JadenNeal/Balance-Car/balance-car.png

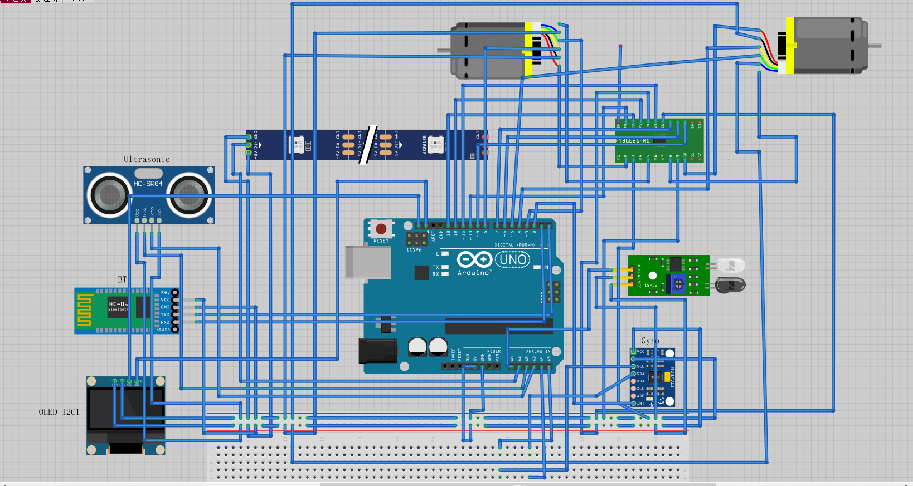
balance-car.png
