JadenNeal/Balance-Car/平衡小车原理图.pdf

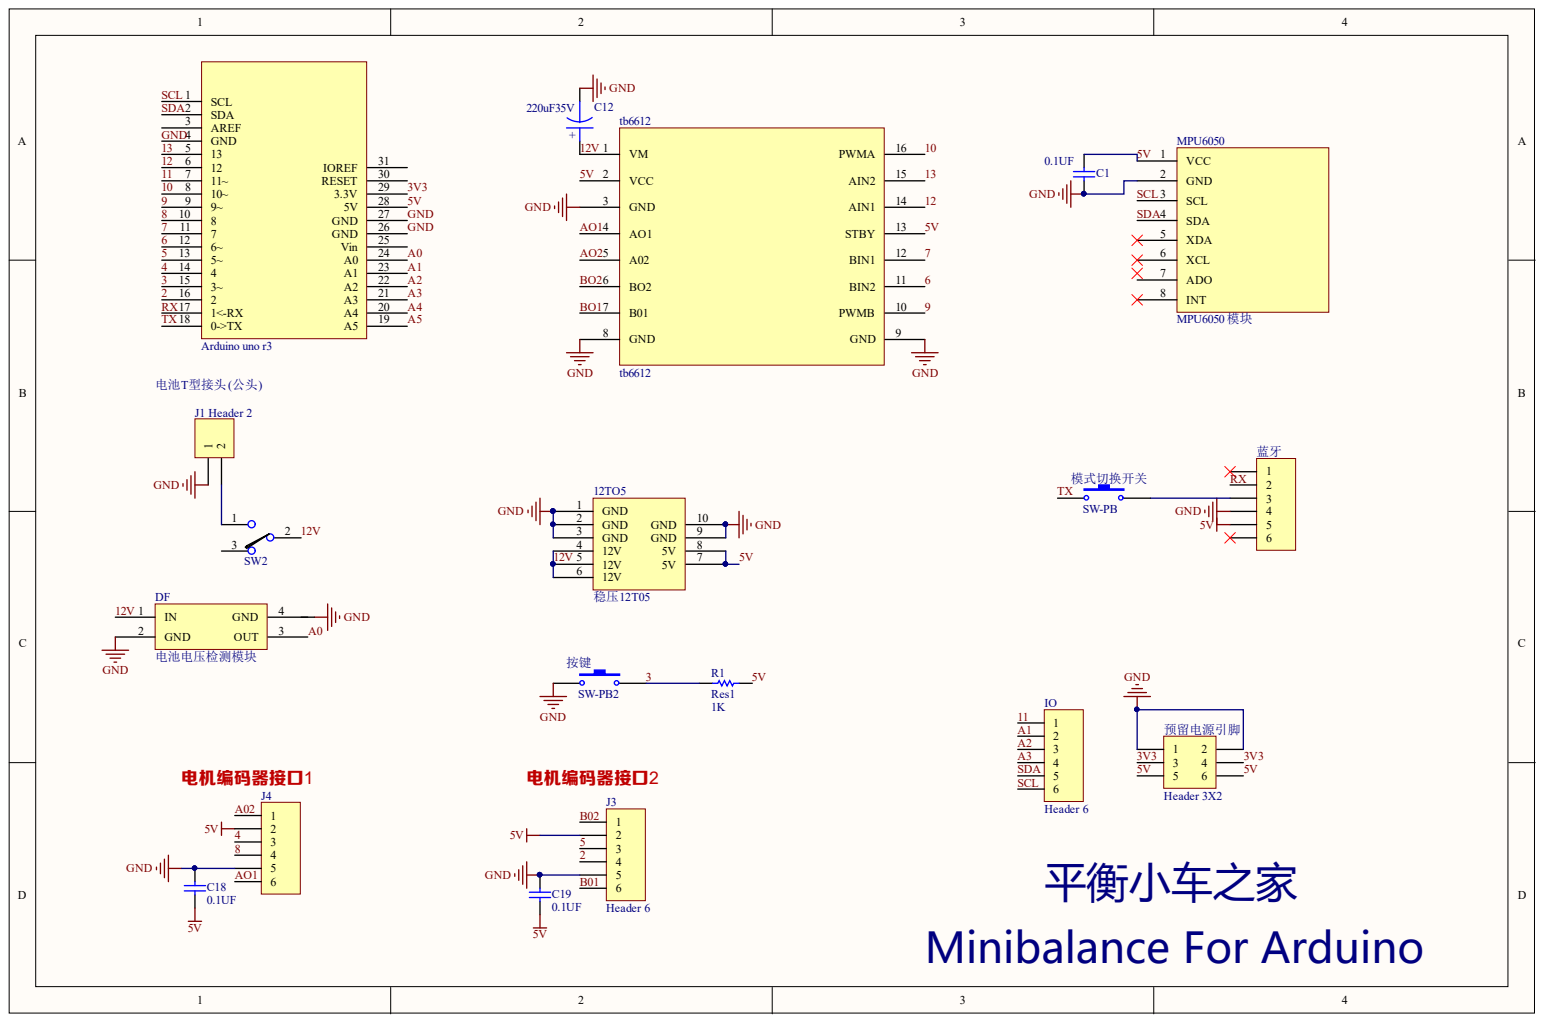
[picture p2: page 1]
