JadenNeal/Balance-Car/TEST_NOTES/20190708/离线测试笔记.md

# 离线测试笔记
目标：不使用USB接电脑供电，由于缺少直流电源线，故只能使用VIN接口给板子供电。
## 蓝牙控制电机
由于**蓝牙控制电机**的功能还没有测试好，故先测试这部分。

接线如下：

1. 蓝牙(HC-06)
    + RX -- 3（板子的发射端）
    + TX -- 2（板子的接收端）
    + GND -- GND
    + VCC -- VCC
2. 电机驱动(TB6612)
    + PWMA -- 10
    + AIN2 -- 13
    + AIN1 -- 12
    + STBY -- 11
    + BIN1 -- 7
    + BIN2 -- 6
    + PWMB -- 9
    + GND -- GND
    + VM -- 12
    + VCC -- 5V
    + AO1 -- AO1
    + AO2 -- AO2
    + BO2 -- BO2
    + BO1 -- BO1
3. 电机A
    + AO2
    + 5V
    + 4
    + 8
    + GND(并联0.1uf的旁路电容)
    + AO1（正极）
4. 电机B
    + BO1（正极）
    + GND(并联0.1uf的旁路电容)
    + 2
    + 5
    + BO2

完整程序在[这里](https://github.com/JadenNeal/Balance-Car/blob/master/others/BT_and_Motor/BT_and_Motor.ino)。

连接完成后，给板子上电，上传程序。然后用手机连接蓝牙，发送对应的数字即可控制电机转动。

## 串口控制电机
相比较蓝牙控制，串口控制就显得简单得多。思路就是读取发送到串口的数据，根据该数据控制电机转动。

只需要连接电机驱动模块和电机，程序在[这里](https://github.com/JadenNeal/Balance-Car/blob/master/others/Serial_and_Motor/Serial_and_Motor.ino)。

结果如下：
<div align="center">串口控制电机</div>

## 完整接线图
1. 超声波 
    + GND -- GND
    + Echo -- A3
    + Trig -- A2
    + VCC -- 5V
2. 蓝牙(HC-06) 
    + RX -- 1（板子的发射端）
    + TX -- 0（板子的接收端）
    + GND -- GND
    + VCC -- VCC
3. 显示屏(HW-102)  
    + VCC -- 5V
    + GND -- GND
    + SCL -- SCL
    + SDA -- SDA
4. 电机驱动(TB6612)
    + PWMA -- 10
    + AIN2 -- 13
    + AIN1 -- 12
    + STBY -- 11
    + BIN1 -- 7
    + BIN2 -- 6
    + PWMB -- 9
    + GND -- GND
    + VM -- 12V
    + VCC -- 5V
    + GND -- GND
    + AO1 -- AO1
    + AO2 -- AO2
    + BO2 -- BO2
    + BO1 -- BO1
    + GND -- GND
5. 陀螺仪(MPU6050) 
    + VCC -- 5V
    + GND -- GND
    + SCL -- A5
    + SDA -- A4
    + INT -- 2
    + 最好在VCC和GND之间加个0.1uf的旁路电容
6. 电机A
    + AO2
    + 5V
    + 3
    + 8
    + GND(并联0.1uf的旁路电容)
    + AO1（正极）
7. 电机B
    + BO1（正极）
    + GND(并联0.1uf的旁路电容)
    + 4
    + 5
    + 5V
    + BO2
8. 全彩LED  
    + IN -- A1
    + VCC -- 5V
    + GND -- GND
9. 红外对管  
    + OUT -- A0
    + GND -- GND
    + VCC -- VCC

<div align="center">

空余的为12V电池接口</div>
