JadenNeal/Balance-Car/TEST_NOTES/20190709/PID简述.md

# PID简述
具体的参见[SUNPLUS的PID教程](http://gfiles.chinaaet.com/woolf/group/20160424/164-6359711596015700001928132.pdf)

<div align="center">

PID的形象描述</div>
