JadenNeal/Balance-Car/TEST_NOTES/20190715/调试笔记03.md

# 问题汇总
速度环的极性。  
极性的确定，有什么决定？一定要修改正负号？
解决轮胎正反转的问题，陀螺仪，输出的真值表，kp和kd的正负值，电机的正负。  

## 考核要求
周四时候，每人两分钟。PPT以大组为单位出。按照8人演讲顺序给老师自己的材料（笔记、日志等）。
