JadenNeal/Balance-Car/(commit log)

2019-07-07 Gyro and motors
2019-07-07 Gyro calibration
2019-07-07 test for full LED
2019-07-07 Union test for infraed and LED
2019-07-08 UNO板说明
2019-07-08 BT and motor
2019-07-08 Add Serial and motor
2019-07-08 采用VIN供电测试
2019-07-09 Gyro MPU6050
2019-07-09 the final schematic
2019-07-09 add PID
2019-07-10 for drawing the schematic
2019-07-12 update motor
2019-07-14 add 调试笔记01
2019-07-16 add 调试笔记02.md
2019-07-17 调试笔记03
2019-07-17 add 调试笔记04
2019-07-17 实现了小车平衡
